joeferner/stm32-network-rs232/docs/enc28j60-reference-design.png

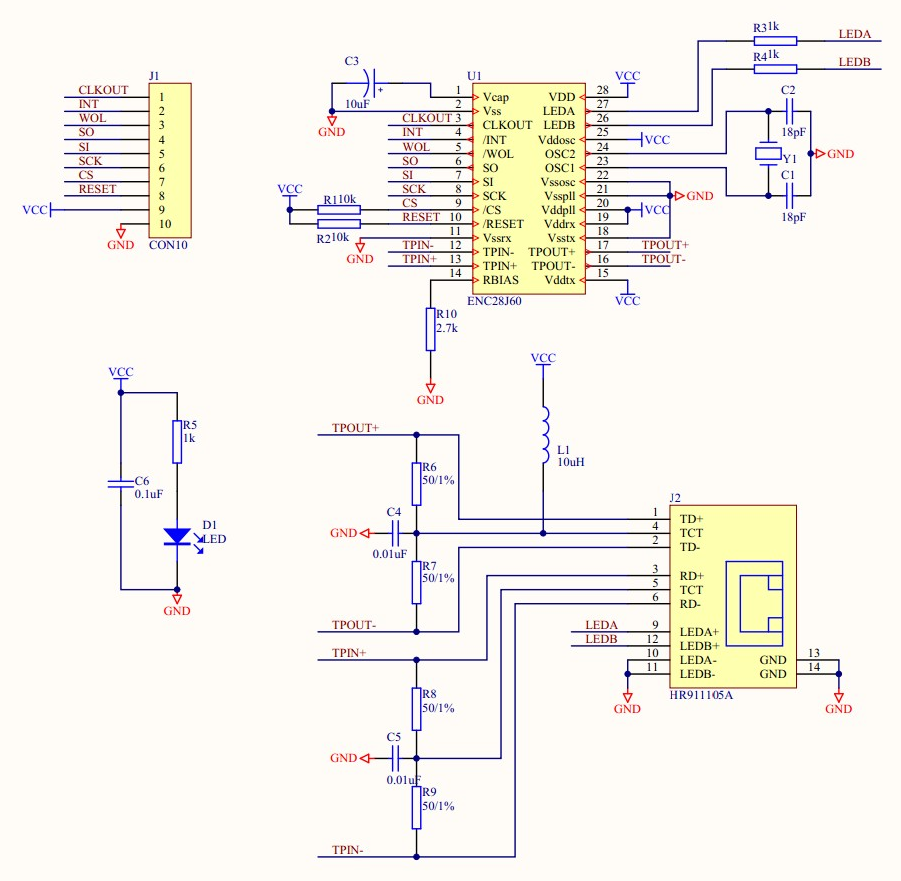
docs/enc28j60-reference-design.png
