joeferner/stm32-network-rs232/hardware/stm32-network-rs232.kicad_pcb

## KiCad design hardware/stm32-network-rs232.kicad_pcb (2015-04-07)

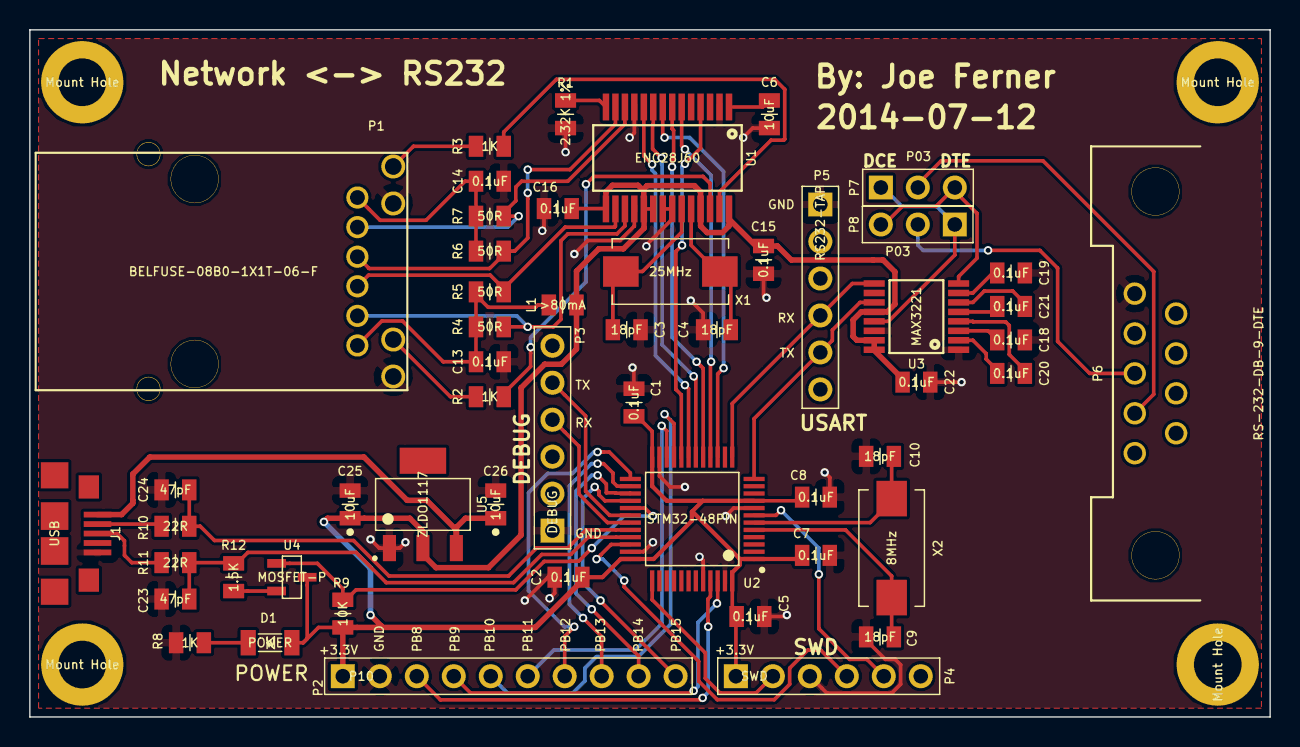
[picture p2: board stm32-network-rs232.kicad_pcb from above]

Board: 2 copper layers, 85.2 x 47.2 mm, 57 parts (0 on the bottom side), 57 nets.

Parts:
C1, C2, C5, C7, C8, C13, C14, C15, C16, C18, C19, C20, C21, C22: 0.1uF; CAPC2012X100N
C3, C4, C9, C10: 18pF; CAPC2012X100N
C6: 10uF; CAPC2012X100N
C23, C24: 47pF; CAPC2012X100N
C25, C26: 10uF; CAPCP2012X100N
D1: POWER; LEDC3216X100N
J1: USB; JST_UB-MC5BR3-SD204-4S-NMP
L1: >80mA; RESC2012X100N
M1, M2, M3, M4: Mount Hole; MTGNP565H328Z565P
P1: BELFUSE-08B0-1X1T-06-F; BEL-FUSE-08B0-1X1T-06-F
P2: P10; HDRV10W66P254_1X10_1006X249X838P
P3: DEBUG; HDRV6W66P254_1X6_1524X249X838P
P4: SWD; HDRV6W66P254_1X6_1524X249X838P
P5: RS232-TAP; HDRV6W66P254_1X6_1524X249X838P
P6: RS-232-DB-9-DTE; TECONN-5747840-2
P7, P8: P03; HDRV3W66P254_1X3_762X249X838P
R1: 2.32K 1%; RESC2012X100N
R2, R3, R8: 1K; RESC2012X100N
R4, R5, R6, R7: 50R; RESC2012X100N
R9: 10K; RESC2012X100N
R10, R11: 22R; RESC2012X100N
R12: 1.5K; RESC2012X100N
U1: ENC28J60; SOP65P780X200-28N
U2: STM32-48PIN; QFP50P900X900X160-48N
U3: MAX3221; SOP65P640X120-16N
U4: MOSFET-P; SOT95P237X112_123-3N
U5: ZLDO1117; SOT230P700X180-4N
X1: 25MHz; XTAL8045X200N
X2: 8MHz; XTAL8045X200N

Connections:
+3.3V: C1.2, C2.2, C5.2, C7.2, C8.2, C15.2, C16.2, C22.1, C25.1, D1.1, L1.1, P2.1, P4.1, R9.2, U1.15, U1.19, U1.20, U1.25, U1.28, U2.1, U2.9, U2.24, U2.36, U2.48, U3.12, U3.15, U3.16, U4.3, U5.2
+5V: C26.1, J1.1, U5.3
/DB9RX: P6.2, P7.2
/DB9TX: P6.3, P8.2
/ENC28J60CS: U1.9, U2.18
/ENC28J60INT: U1.4, U2.20
/ENC28J60RESET: U1.10, U2.19
/RS232RX: P7.3, P8.3, U3.8
/RS232TX: P7.1, P8.1, U3.13
/SPIMISO: U1.6, U2.16
/SPIMOSI: U1.7, U2.17
/SPISCK: U1.8, U2.15
/SWCLK: P4.2, U2.37
/SWDIO: P4.4, U2.34
/USART1RX: P3.4, U2.31
/USART1TX: P3.5, U2.30
/USART2RX: P5.4, U2.13, U3.9
/USART2TX: P5.5, U2.12, U3.11
/USBDIS: R9.1, U2.29, U4.1
/USBDM: C24.1, R10.1, U2.32
/USBDP: C23.1, R11.1, R12.1, U2.33
/nRST: P4.5, U2.7
GNDPWR: C1.1, C2.1, C3.2, C4.2, C5.1, C6.2, C7.1, C8.1, C9.2, C10.2, C13.1, C14.1, C15.1, C16.1, C18.2, C19.2, C22.2, C23.2, C24.2, C25.2, C26.2, J1.5, P1.7, P1.9, P2.2, P3.1, P4.3, P5.1, P6.5, R1.1, R8.1, U1.2, U1.11, U1.18, U1.21, U1.22, U2.8, U2.23, U2.35, U2.44, U2.47, U3.1, U3.14, U5.1
unnamed: C3.1, U1.23, X1.1
unnamed: C4.1, U1.24, X1.2
unnamed: C6.1, U1.1
unnamed: C9.1, U2.5, X2.1
unnamed: C10.1, U2.6, X2.2
unnamed: C13.2, L1.2, P1.1, R4.1, R5.2
unnamed: C14.2, P1.6, R6.1, R7.2
unnamed: C18.1, U3.3
unnamed: C19.1, U3.7
unnamed: C20.1, U3.2
unnamed: C20.2, U3.4
unnamed: C21.1, U3.5
unnamed: C21.2, U3.6
unnamed: D1.2, R8.2
unnamed: J1.2, R10.2
unnamed: J1.3, R11.2
unnamed: P1.2, R4.2, U1.17
unnamed: P1.3, R5.1, U1.16
unnamed: P1.4, R6.2, U1.13
unnamed: P1.5, R7.1, U1.12
unnamed: P1.8, R2.2
unnamed: P1.10, R3.2
unnamed: P2.3, U2.45
unnamed: P2.4, U2.46
unnamed: P2.5, U2.21
unnamed: P2.6, U2.22
unnamed: P2.7, U2.25
unnamed: P2.8, U2.26
unnamed: P2.9, U2.27
unnamed: P2.10, U2.28
unnamed: R1.2, U1.14
unnamed: R2.1, U1.26
unnamed: R3.1, U1.27
unnamed: R12.2, U4.2
