joeferner/stm32-network-rs232/firmware/src/interrupts.c

#include "platform_config.h"

void NMI_Handler() {
}

void HardFault_Handler() {
  while (1) {
  }
}

void MemManage_Handler() {
  while (1) {
  }
}

void BusFault_Handler() {
  while (1) {
  }
}

void UsageFault_Handler() {
  while (1) {
  }
}

void SVC_Handler() {
}

void DebugMon_Handler() {
}

void PendSV_Handler() {
}
