joeferner/stm32-network-rs232/(commit log)

2014-06-24 save/update kicad library
2014-06-24 blink led
2014-07-04 update libs
    [stm32-network-rs232.sch]
2014-07-05 fix pins
    [stm32-network-rs232.sch]
2014-07-05 schematic complete
    [stm32-network-rs232.sch]
2014-07-06 add 3.3V reg
    [stm32-network-rs232.sch]
2014-07-06 more mods
    [stm32-network-rs232.sch]
2014-07-07 add rx/tx toggles
    [stm32-network-rs232.kicad_pcb, stm32-network-rs232.sch]
2014-07-08 more modules
    [stm32-network-rs232.sch]
2014-07-09 initial layout
    [stm32-network-rs232.kicad_pcb, stm32-network-rs232.sch]
2014-07-09 update kicadlib
2014-07-09 update from kicadlib
2014-07-09 upgrade to new modules part 1
    [stm32-network-rs232.kicad_pcb, stm32-network-rs232.sch]
2014-07-12 board routing
    [stm32-network-rs232.kicad_pcb]
2014-07-12 board layout complete
    [stm32-network-rs232.kicad_pcb]
2014-07-12 increase power trace widths
    [stm32-network-rs232.kicad_pcb]
2014-07-12 more board changes
    [stm32-network-rs232.kicad_pcb]
2014-07-19 update footprints
    [stm32-network-rs232.kicad_pcb]
2014-07-19 update kicad lib
2014-07-19 line up labels
    [stm32-network-rs232.kicad_pcb]
2014-08-01 add manufacturer part numbers
    [stm32-network-rs232.sch]
2014-08-03 move usb port in a little
    [stm32-network-rs232.kicad_pcb]
2014-08-05 initial work of converting usart rx to dma
2014-08-05 refactor rs232 usart to use dma
2014-08-06 usart dma working
2014-08-06 contiki upgrade (closes issue #5)
    [contiki-conf.h, network.c, network.h, uip-conf.h]
2014-08-09 nudge usb connector to make more room
2014-09-05 remove kicad-library subtree
2015-04-07 fix pin order on DB-9
    [stm32-network-rs232.kicad_pcb]
2015-04-07 update from kicad-library
2015-04-10 initial move to stm32lib
2015-04-12 move firmware-stm32lib to firmware
2015-04-13 switch to irq
2015-04-14 use interrupts
2015-04-15 fix new line characters
    [rs232.c]
2015-04-21 use git submodules for stm32lib and contiki
2015-05-14 reset after 5 hours
    [main.c]
2015-05-14 remove reset logic since this doesn't fix the problem
    [main.c]
2015-06-14 switched over to using UDP
2015-09-18 update contiki and stm32lib
2015-11-06 new firmware start
    [stm32-network-rs232.sch]
2015-11-06 removed utils, added contiki
    [stm32-network-rs232.sch]
2015-11-07 dma ring buffer
